Jaycar-Electronics/Arcade-Joystick/images/NPI00012c.jpg

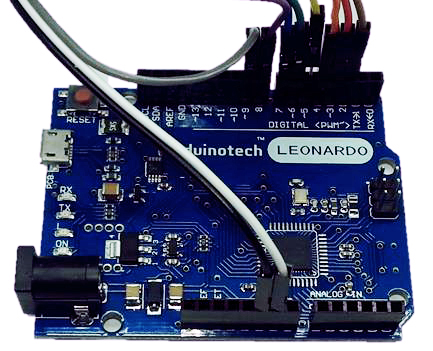
images/NPI00012c.jpg
