Jaycar-Electronics/Arcade-Joystick/images/NPI00012d.jpg

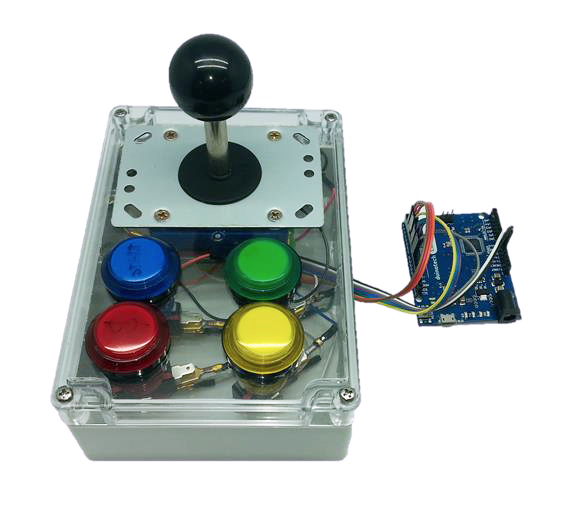
images/NPI00012d.jpg
